VentoTran/HUST_WIRELESS_SENSOR_NETWORK_20221/README.md

# HUST_WIRELESS_SENSOR_NETWORK_20221
Project Final for Wireless Sensor Network class in HUST 20221
