VentoTran/HUST_WIRELESS_SENSOR_NETWORK_20221/HARDWARE/GATEWAY/WSN_PCB.PcbDoc.htm

Reporting Options

# File in Previous Format

Date | : | 2/8/2023
Time | : | 2:40:57 PM
Filename | : | D:\WSN\HUST_WIRELESS_SENSOR_NETWORK_20221\HARDWARE\GATEWAY\WSN_PCB.PcbDoc

Version | Warning

This file was generated by an earlier version of the software
