VentoTran/HUST_WIRELESS_SENSOR_NETWORK_20221/HARDWARE/NODE/WSN_PCB_NODE.PcbDoc.htm

Reporting Options

# File in Previous Format

Date | : | 2/8/2023
Time | : | 3:54:32 PM
Filename | : | D:\WSN\HUST_WIRELESS_SENSOR_NETWORK_20221\HARDWARE\NODE\WSN_PCB_NODE.PcbDoc

Version | Warning

This file was generated by an earlier version of the software
