VentoTran/HUST_WIRELESS_SENSOR_NETWORK_20221/(list of files, drawings)

Other design files:
HARDWARE/GATEWAY/COMM.SchDoc
HARDWARE/GATEWAY/CONN.SchDoc
HARDWARE/GATEWAY/MCU.SchDoc
HARDWARE/GATEWAY/POWER.SchDoc
HARDWARE/GATEWAY/WSN.PrjPCB
HARDWARE/GATEWAY/WSN_PCB.PcbDoc
HARDWARE/NODE/COMM.SchDoc
HARDWARE/NODE/CONN.SchDoc
HARDWARE/NODE/DISPLAY.SchDoc
HARDWARE/NODE/MCU.SchDoc
HARDWARE/NODE/POWER.SchDoc
HARDWARE/NODE/SENSOR.SchDoc
HARDWARE/NODE/WSN_NODE.PrjPCB
HARDWARE/NODE/WSN_PCB_NODE.PcbDoc
