VentoTran/HUST_WIRELESS_SENSOR_NETWORK_20221/FIRMWARE/NODE/WSN_NODE/WSN_NODE.ioc

Mcu.UserName=STM32F103C8Tx
PA1.GPIO_Label=VBAT
PA1.Signal=ADCx_IN1
PA10.Signal=USART1_RX
PA13.Signal=SYS_JTMS-SWDIO
PA14.Signal=SYS_JTCK-SWCLK
PA15.GPIO_Label=LoRa_RST
PA15.Signal=GPIO_Output
PA4.GPIO_Label=CS1
PA4.Signal=GPIO_Output
PA5.GPIO_Label=SCK
PA5.Signal=GPIO_Output
PA7.GPIO_Label=SER
PA7.Signal=GPIO_Output
PA8.GPIO_Label=CS2
PA8.Signal=GPIO_Output
PA9.Signal=USART1_TX
PB0.GPIO_Label=DQ
PB0.Signal=GPIO_Output
PB10.GPIO_Label=DIG2
PB10.Signal=GPIO_Output
PB11.GPIO_Label=DIG3
PB11.Signal=GPIO_Output
PB12.GPIO_Label=LoRa_EXTI2
PB12.Signal=GPXTI12
PB13.Signal=SPI2_SCK
PB14.Signal=SPI2_MISO
PB15.Signal=SPI2_MOSI
PB3.GPIO_Label=BT0
PB3.Signal=GPXTI3
PB4.GPIO_Label=BT1
PB4.Signal=GPXTI4
PB5.GPIO_Label=BT2
PB5.Signal=GPXTI5
PB8.GPIO_Label=DIG0
PB8.Signal=GPIO_Output
PB9.GPIO_Label=DIG1
PB9.Signal=GPIO_Output
PC13-TAMPER-RTC.GPIO_Label=LED0
PC13-TAMPER-RTC.Signal=GPIO_Output
PC14-OSC32_IN.GPIO_Label=LED1
PC14-OSC32_IN.Signal=GPIO_Output
PC15-OSC32_OUT.GPIO_Label=LED2
PC15-OSC32_OUT.Signal=GPIO_Output
PD0-OSC_IN.Signal=RCC_OSC_IN
PD1-OSC_OUT.Signal=RCC_OSC_OUT
