VentoTran/HUST_WIRELESS_SENSOR_NETWORK_20221/FIRMWARE/NODE/WSN_NODE/Core/Inc/main.h

#define LED0_Pin GPIO_PIN_13
#define LED0_GPIO_Port GPIOC
#define LED1_Pin GPIO_PIN_14
#define LED1_GPIO_Port GPIOC
#define LED2_Pin GPIO_PIN_15
#define LED2_GPIO_Port GPIOC
#define VBAT_Pin GPIO_PIN_1
#define VBAT_GPIO_Port GPIOA
#define CS1_Pin GPIO_PIN_4
#define CS1_GPIO_Port GPIOA
#define SCK_Pin GPIO_PIN_5
#define SCK_GPIO_Port GPIOA
#define SER_Pin GPIO_PIN_7
#define SER_GPIO_Port GPIOA
#define DQ_Pin GPIO_PIN_0
#define DQ_GPIO_Port GPIOB
#define DIG2_Pin GPIO_PIN_10
#define DIG2_GPIO_Port GPIOB
#define DIG3_Pin GPIO_PIN_11
#define DIG3_GPIO_Port GPIOB
#define LoRa_EXTI2_Pin GPIO_PIN_12
#define LoRa_EXTI2_GPIO_Port GPIOB
#define LoRa_EXTI2_EXTI_IRQn EXTI15_10_IRQn
#define CS2_Pin GPIO_PIN_8
#define CS2_GPIO_Port GPIOA
#define LoRa_RST_Pin GPIO_PIN_15
#define LoRa_RST_GPIO_Port GPIOA
#define BT0_Pin GPIO_PIN_3
#define BT0_GPIO_Port GPIOB
#define BT0_EXTI_IRQn EXTI3_IRQn
#define BT1_Pin GPIO_PIN_4
#define BT1_GPIO_Port GPIOB
#define BT1_EXTI_IRQn EXTI4_IRQn
#define BT2_Pin GPIO_PIN_5
#define BT2_GPIO_Port GPIOB
#define BT2_EXTI_IRQn EXTI9_5_IRQn
#define DIG0_Pin GPIO_PIN_8
#define DIG0_GPIO_Port GPIOB
#define DIG1_Pin GPIO_PIN_9
#define DIG1_GPIO_Port GPIOB
