VentoTran/HUST_WIRELESS_SENSOR_NETWORK_20221/FIRMWARE/NODE/WSN_NODE/Core/Inc/common.h

/*
 * common.h
 *
 *  Created on: Feb 8, 2023
 *      Author: dung
 */

#ifndef INC_COMMON_H_
#define INC_COMMON_H_

void LOG(const char *TAG, char *data);
void ftoa(double n, char* res, int afterpoint);
#endif /* INC_COMMON_H_ */
