VentoTran/HUST_WIRELESS_SENSOR_NETWORK_20221/(commit log)

2022-12-28 done schematic v1.0
    [COMM.SchDoc, CONN.SchDoc, DISPLAY.SchDoc, MCU.SchDoc, POWER.SchDoc, SENSOR.SchDoc, WSN.PrjPCB, WSN_NODE.PrjPCB]
2022-12-29 done PCB
    [COMM.SchDoc, DISPLAY.SchDoc, MCU.SchDoc, POWER.SchDoc, SENSOR.SchDoc, WSN_PCB.PcbDoc, WSN_PCB_NODE.PcbDoc]
2023-01-31 31012023
    Dung push sx1278 driver
2023-02-08 config stm32
2023-02-09 pull lora lib
    [WSN_PCB_NODE.PcbDoc]
2023-02-10 done NODE temperature, battery and sleep
