VentoTran/HUST_WIRELESS_SENSOR_NETWORK_20221/(notices)

Notices in the files:
FIRMWARE/NODE/WSN_NODE/Core/Inc/main.h:
Copyright (c) 2022 STMicroelectronics.
All rights reserved.
This software is licensed under terms that can be found in the LICENSE file
